tymokhin/VoltageImitator/firmware/STM32CubeIDE/вибір-платформи.md

# Вибір платформи для наступної ревізії імітатора

Вхідні вимоги: HRTIM, Ethernet на борту, **максимально точна синхронізація в
часі**, у перспективі IEC 61850 (не зараз), в ідеалі **8 силових каналів**
(4 напруги + 4 струми).

---

## 1. Перетин «HRTIM + Ethernet» — рівно одна лінійка

За таблицею застосовності в AN4539 «HRTIM cookbook» (Rev 5, червень 2025)
HRTIM існує лише в трьох сімействах STM32:

| Сімейство | HRTIM | Роздільність | Timing units | Виходів | Ethernet MAC |
|---|---|---|---|---|---|
| STM32F334 (поточний) | v1 | 217 пс | 5 | 10 | ✗ |
| STM32G474 / G484 | v2 | **184 пс** | 6 | 12 | ✗ |
| **STM32H742/743/750/753** | v1 | **2.08 нс** | 5 | 10 | ✓ + IEEE 1588 |
| **STM32H745/747/755/757** (2 ядра) | v1 | 2.08 нс | 5 | 10 | ✓ + IEEE 1588 |
| STM32H723/725/730/733/735 | ✗ | — | — | — | ✓ |
| STM32H7R/S (600 МГц, 2024) | ✗ | — | — | — | ✓ |
| STM32H5 (H563/H573) | ✗ | — | — | — | ✓ |

Два висновки, які легко пропустити:

- **«Потужніший» ≠ «має HRTIM».** H723/H725 (550 МГц) і найновіші H7R/S
  (600 МГц) HRTIM не мають узагалі, попри те що вони швидші за H743.
- **На H7 HRTIM у ~10 разів грубіший, ніж на G4 і навіть ніж на твоєму
  поточному F334.** У F3 і G4 є DLL із множенням ×32 (еквівалент 4.6–5.4 ГГц).
  На H7 його немає: HRTIM тактується напряму від 480 МГц, звідси 2.08 нс.
  Це підтверджують два незалежні документи ST.

### Що це коштує в бітах

При PWM 100 кГц (період 10 мкс):

| Чіп | Кроків duty | Ефективних біт |
|---|---|---|
| F334 (зараз) | 46 080 | 15.5 |
| G474 | 54 348 | 15.7 |
| **H743** | **4 808** | **12.2** |

Перехід на H7 заради Ethernet коштує ~3.3 біта роздільності силового каналу.

**Чому це, найімовірніше, все одно прийнятно:**

- замкнений контур виправляє середнє — квантування лишається шумом, а не
  похибкою амплітуди;
- передискретизація величезна: PWM 100 кГц проти сигналу 0–1 кГц дає
  OSR ≈ 50, тобто ~17 дБ (майже 3 біти) виграшу в смузі, якщо похибка біла;
- LC-фільтр давить решту.

**Чому про це все одно треба пам'ятати:** похибка квантування PWM НЕ біла —
вона корельована із сигналом і вилазить саме як зайві гармоніки. Для
імітатора РЗА, де 2-а гармоніка подається на рівні 15 %, а 5-а на 25 %, це
принципово. Лікується **дизерингом молодшого біта duty** (±1 LSB
псевдовипадково щотакту) — дешево, кілька рядків у гарячому циклі.

Запасний хід, якщо 12.2 біта виявляться замалими: знизити PWM до 50 кГц
(9 615 кроків = 13.2 біта) або до 20 кГц (24 038 = 14.6 біта), заплативши
складнішим фільтром.

---

## 2. Чи влізуть 8 каналів в один чіп

**Так — але за однієї умови.**

Рахунок виходів HRTIM: 5 timing units × 2 виходи = **10 виходів** на H743.
Питання лише в тому, скільки виходів з'їдає один канал, а це визначає
топологія силової частини:

| Топологія | Виходів на канал | Каналів на H743 | На G474 |
|---|---|---|---|
| Один PWM, комплементарну пару й deadtime робить драйвер затворів | 1 | **10** | 12 |
| Півміст із апаратним deadtime від HRTIM | 2 (весь timing unit) | 5 | 6 |
| Повний H-міст від HRTIM | 4 (2 units) | 2 | 3 |

Тобто **8 каналів влізуть, якщо deadtime віддати драйверам** (IR2104,
UCC27211 і подібні генерують комплементарну пару з одного входу PWM).
Якщо хочеш апаратний deadtime усередині HRTIM — стеля 5 каналів на H743
і 6 на G474, і 8 не виходить у жодному разі на одному чіпі.

Два виходи одного timing unit ділять період, але мають незалежні CMP1/CMP2 —
цей трюк уже використаний у поточній прошивці (TA1/TA2 на таймері A).
Оскільки всі канали й так працюють на 100 кГц, спільний період не заважає.

> **Перевірити перед розведенням:** скільки виходів HRTIM фізично виведено
> в обраному корпусі. У 48-вивідному F334C8 доступна лише частина; у
> LQFP144/176 на H743 ситуація краща, але це треба звірити по таблиці
> альтернативних функцій у datasheet, а не припускати.

### Бюджет ядра — перестає бути проблемою

Поточний такт (4 канали × 10 гармонік) ≈ 1800–2000 тактів на M4 @ 72 МГц.
M7 @ 480 МГц дає приблизно 1.7× по IPC плюс кеш. Оцінка для 8 каналів:

- ~2 400 тактів M7 ≈ **5 мкс**;
- при PWM 100 кГц (10 мкс) це ~50 % завантаження.

Тобто на H743 **8 каналів × 10 гармонік на повних 100 кГц стають реальними**,
без децимації. Запас усе одно варто лишити — децимація на 2 дає 25 %.

### АЦП — недооцінений аргумент за H7

| | H743 | G474 |
|---|---|---|
| Кількість АЦП | 3 | 5 |
| Роздільність | **16 біт** | 12 біт |
| Швидкодія | до 3.6 Msps | до 4 Msps |

8 каналів ЗЗ на H743 розкладаються 3/3/2. Усередині одного АЦП ранги йдуть
послідовно — при 3.6 Msps три ранги це ~1–1.5 мкс перекосу. Для 50 Гц це
0.02°, тобто нехтовно.

**Ключова думка: точність замкненого контуру обмежена датчиком, а не
виконавчим органом.** Регулятор виправляє рівно те, що бачить. Перехід
12 → 16 біт на вимірюванні дає більше, ніж 3 біти PWM, які контур і
фільтр здебільшого згладжують. Це серйозно схиляє шальки до H7, попри
грубіший HRTIM.

---

## 3. Синхронізація в часі — головна вимога

Тут є три речі, які варто розділити.

### PTP — не найточніший варіант

- **GNSS PPS:** 10–50 нс до UTC, без залежності від мережі. Пін PPS у
  твоїй схемі вже є.
- **PTP (IEEE 1588v2) з апаратним мітками часу:** зазвичай суб-мікросекунда,
  ~100 нс — але **лише якщо весь шлях PTP-aware** (boundary/transparent
  clocks у комутаторах). У звичайній мережі буде помітно гірше.
- **IRIG-B:** ~1 мкс, класика для підстанцій.

Тобто якщо мета — максимальна точність, **основним джерелом має бути GNSS
PPS**, а PTP — резервом на випадок, коли антену не вивести, плюс шлях до
IEC 61850-9-3 у майбутньому. Ethernet заради синхронізації сам по собі
не обов'язковий; він потрібен для 61850 і зручності.

### Обмежувач точності — кварц, а не мікроконтролер

Звичайний кварц ±10 ppm дає дрейф 10 мкс за секунду — це **0.18° від 50 Гц
між імпульсами PPS**. Ніякий вибір МК цього не виправить.

| Джерело | Стабільність | Дрейф фази 50 Гц за 1 с |
|---|---|---|
| Кварц ±10 ppm | 10 ppm | 0.18° |
| TCXO ±0.5 ppm | 0.5 ppm | 0.009° |
| Малий OCXO ±0.01 ppm | 0.01 ppm | 0.0002° |

**Заміна кварцу на TCXO (а краще OCXO) на вході HSE — більший важіль
точності, ніж вибір між H743 і G474.** Це найдешевше покращення в усьому
проєкті.

### Дисциплінувати треба фазу хвилі, а не таймбазу PWM

Спокуса — підстроювати HRTIM під PPS. Не треба: це ламає і період PWM, і
частоту АЦП, і весь розрахунок регулятора.

Правильно: лишити HRTIM вільно бігти від кварцу, а дисциплінувати
**фазовий акумулятор**. Він уже Q32, тобто крок `phase_step` можна
підкручувати на одиниці ppb — це керує фазою вихідного сигналу з
роздільністю, недосяжною для будь-якого підстроювання таймера.

Схема:

1. Захопити PPS входом таймера (input capture).
2. Порівняти з лічильником тактів контуру → похибка фази.
3. Повільний ФАПЧ (смуга частки герца) підкручує `phase_step` усіх каналів
   однаково.

Це чисто прошивкова функція, працює на будь-якому з розглянутих чіпів,
і поточна структура коду (`WgPhaseStep`, `phase_acc` на канал) уже під неї
готова — треба додати спільний множник корекції.

Бонус H743: блок PTP має вихід PPS, тобто можна **видавати** власний PPS і
на осцилографі звіряти GNSS проти PTP проти власної шкали.

---

## 4. Один чіп, два чіпи чи двоядерний

### Двоядерний H747/H755 — не рекомендую як перший крок

Виглядає привабливо (M7 на мережу, M4 на контур), але це фактично два
проєкти в одному корпусі, плюс специфічні граблі:

- M7 має D-cache, M4 не має → спільну пам'ять треба вручну позначати
  non-cacheable через MPU, інакше отримуєш плаваючі баги когерентності;
- синхронізація через HSEM;
- послідовність завантаження двох ядер, два сеанси відладки, дві збірки.

Для людини, яка з двоядерними не працювала, це помітний ризик — а виграш
малий, бо одноядерний H743 на 480 МГц і так має запас і на контур, і на lwIP.

### Два окремі чіпи (G474 + мережевий) — план Б

Має сенс, **якщо роздільність PWM виявиться критичною**. G474 — це буквально
чіп під цю задачу:

- HRTIM v2, 184 пс, 6 timing units / 12 виходів;
- **CORDIC** — апаратний sin/cos, викидає LUT із гарячого циклу;
- **FMAC** — апаратний FIR/IIR, може рахувати резонатор без CPU;
- 5 АЦП, 7 компараторів і 6 ОП на кристалі (аналогове узгодження й
  апаратний захист по струму прямо в МК).

Ціна: два проєкти, два тулчейни, протокол по SPI між чіпами.

### Рекомендація: одноядерний STM32H743 / H753

| Аргумент | |
|---|---|
| Єдине сімейство з HRTIM + Ethernet + IEEE 1588 | ✓ |
| 480 МГц M7 — бюджет ядра перестає бути обмеженням | ✓ |
| 16-бітні АЦП замість 12-бітних — реальний виграш точності контуру | ✓ |
| 1 МБ RAM — жодних танців із CCM | ✓ |
| 10 виходів HRTIM → 8 каналів влізають | ✓ |
| Один проєкт, HAL той самий, код портується майже прямо | ✓ |
| HRTIM 2.08 нс замість 217 пс | ✗ (лікується дизерингом) |

H753 замість H743 — якщо колись знадобиться криптографія (наприклад,
захищений доступ до приладу). Різниця тільки в цьому.

---

## 5. Альтернатива поза ST: TI C2000 F2838x — ВІДХИЛЕНО

Чесно кажучи, для цієї задачі TMS320F28388D підходить **краще за H743**:

| | F28388D | STM32H743 |
|---|---|---|
| Ядра | 2× C28x @200 МГц + Cortex-M4 @125 МГц | 1× M7 @480 МГц |
| PWM | 32 канали, з них 16 високої роздільності | 10 виходів HRTIM |
| Ethernet | 10/100 з 1588 | 10/100 з 1588 |
| АЦП | 4×, 16 біт @1.1 Msps або 12 біт @3.5 Msps | 3×, 16 біт @3.6 Msps |
| Мережа | окремий M4 «connectivity manager» — не заважає реального часу | той самий M7 |

HRPWM у C2000 класу ~150 пс, тобто кращий за H7 і зіставний із G4. Плюс
виділений M4 під мережу — реально-часові ядра не смикаються стеком TCP/IP.

**Але:** повністю інша екосистема (Code Composer Studio, компілятор C28x,
driverlib замість HAL). Наявний код не портується, крива навчання реальна.

**Рішення: відхилено.** Немає досвіду з TI, а починати новий продукт
одночасно з новою екосистемою — це складати два ризики. Виграш у
роздільності PWM того не вартий, тим паче що його можна перевірити
експериментом (розділ 6) і, за потреби, закрити дизерингом або
переходом на G474, лишаючись у знайомому GCC/HAL.

---

## 6. Порядок дій

> **Рішення прийняте: STM32H743 (або H753), одноядерний.**
> TI відхилено через відсутність досвіду з екосистемою. Двоядерний H747
> відхилено як зайвий ризик на першому кроці. G474 + окремий мережевий
> чіп лишається планом Б на випадок, якщо крок 0 нижче провалиться.

### Крок 0 — зробити ПЕРШИМ, на наявній платі F334

Єдине неперевірене припущення в усьому рішенні — чи прийнятні 12.2 біта
PWM. Його не треба перевіряти на новому залізі: 46080 / 4808 = 9.6, тому
квантування compare кроком 10 тіків емулює H743 прямо в поточному тракті.

У прошивку додано дві константи (`WG_DUTY_QUANT_TICKS`, `WG_DUTY_DITHER`)
і дизеринг. Зняти три виміри THD і рівнів 2-ї та 5-ї гармонік при
однаковому завданні:

| `QUANT` | `DITHER` | Що це |
|---|---|---|
| 0 | — | рідні 15.5 біта, еталон |
| 10 | 0 | H743 у найгіршому випадку |
| 10 | 1 | H743 із пом'якшенням |

Якщо третій близький до першого — H743 безпечний, замовляти Nucleo.
Якщо ближчий до другого — план Б.

### Далі — макет

Не розводити плату одразу. Спочатку макет на Nucleo-144 з H743/H753 —
там RJ45 і PHY вже на борту (ST зараз рекомендує NUCLEO-H753ZI; стара
NUCLEO-H743ZI знята з виробництва).

Перевірити в такому порядку:

1. **HRTIM 2.08 нс через реальний LC-фільтр.** Зібрати один канал,
   замкнути контур, зміряти THD і рівень окремих гармонік. Це **та єдина
   цифра, яка вирішує, чи прийнятний H7 узагалі.** Перевірити окремо
   з дизерингом і без.
2. **Дисциплінування фази по PPS.** Захоплення PPS, повільний ФАПЧ на
   `phase_step`, вимірювання дрейфу фази на осцилографі. Спробувати з
   кварцом і з TCXO, щоб побачити різницю.
3. **lwIP + PTP.** Найпростіше з трьох і найменш ризиковане.

Якщо (1) провалиться — перехід на план Б: G474 на силову частину плюс
окремий мережевий чіп.

Поточну плату на F334 лишити як стенд: на ній зручно доводити регулятор і
силову частину, поки макет H7 тільки збирається.

---

## Джерела

- [AN4539 HRTIM cookbook, Rev 5 (червень 2025)](https://www.st.com/resource/en/application_note/an4539-hrtim-cookbook-stmicroelectronics.pdf) — таблиця застосовності: які сімейства мають HRTIM, роздільність, кількість timing units
- [STM32G4/H7 Digital Power Application Sharing](https://manuals.plus/m/1cf4d2a43a0bee1e43a5e4415d6ce97a58c221965ac72a7ffb454052e28073fd) — 184 пс на G4 проти 2.2 нс на H7
- [STM32H7x3 product brief](https://my.avnet.com/wcm/connect/d6ffc27e-608a-4760-b78c-f9ce36de3c60/AVS-094-E_ST_STM32H7_product-brief.pdf?id=1516619058577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) — Ethernet MAC 10/100 з IEEE 1588, 3× 16-бітних АЦП, high-resolution timer
- [STM32H7R3A8 datasheet](https://mm.digikey.com/Volume0/opasdata/d220001/medias/docus/8909/stm32h7r3a8.pdf) — підтвердження, що H7R/S має Ethernet, але не має HRTIM
- [STM32H72x/H73x product overview](https://www.st.com/resource/en/product_presentation/microcontrollers_stm32h72x-3x_line_product-overview.pdf) — 550 МГц лінійка
- [TMS320F28388D datasheet](https://www.ti.com/lit/ds/symlink/tms320f28388d.pdf) — 32 PWM-канали (16 високої роздільності), Ethernet 1588, 4× АЦП 16 біт
- [NUCLEO-H743ZI / H753ZI](https://www.st.com/en/evaluation-tools/nucleo-h743zi.html) — макетна плата з Ethernet
