tymokhin/VoltageImitator/hardware/v1/VoltageImitator.pdf

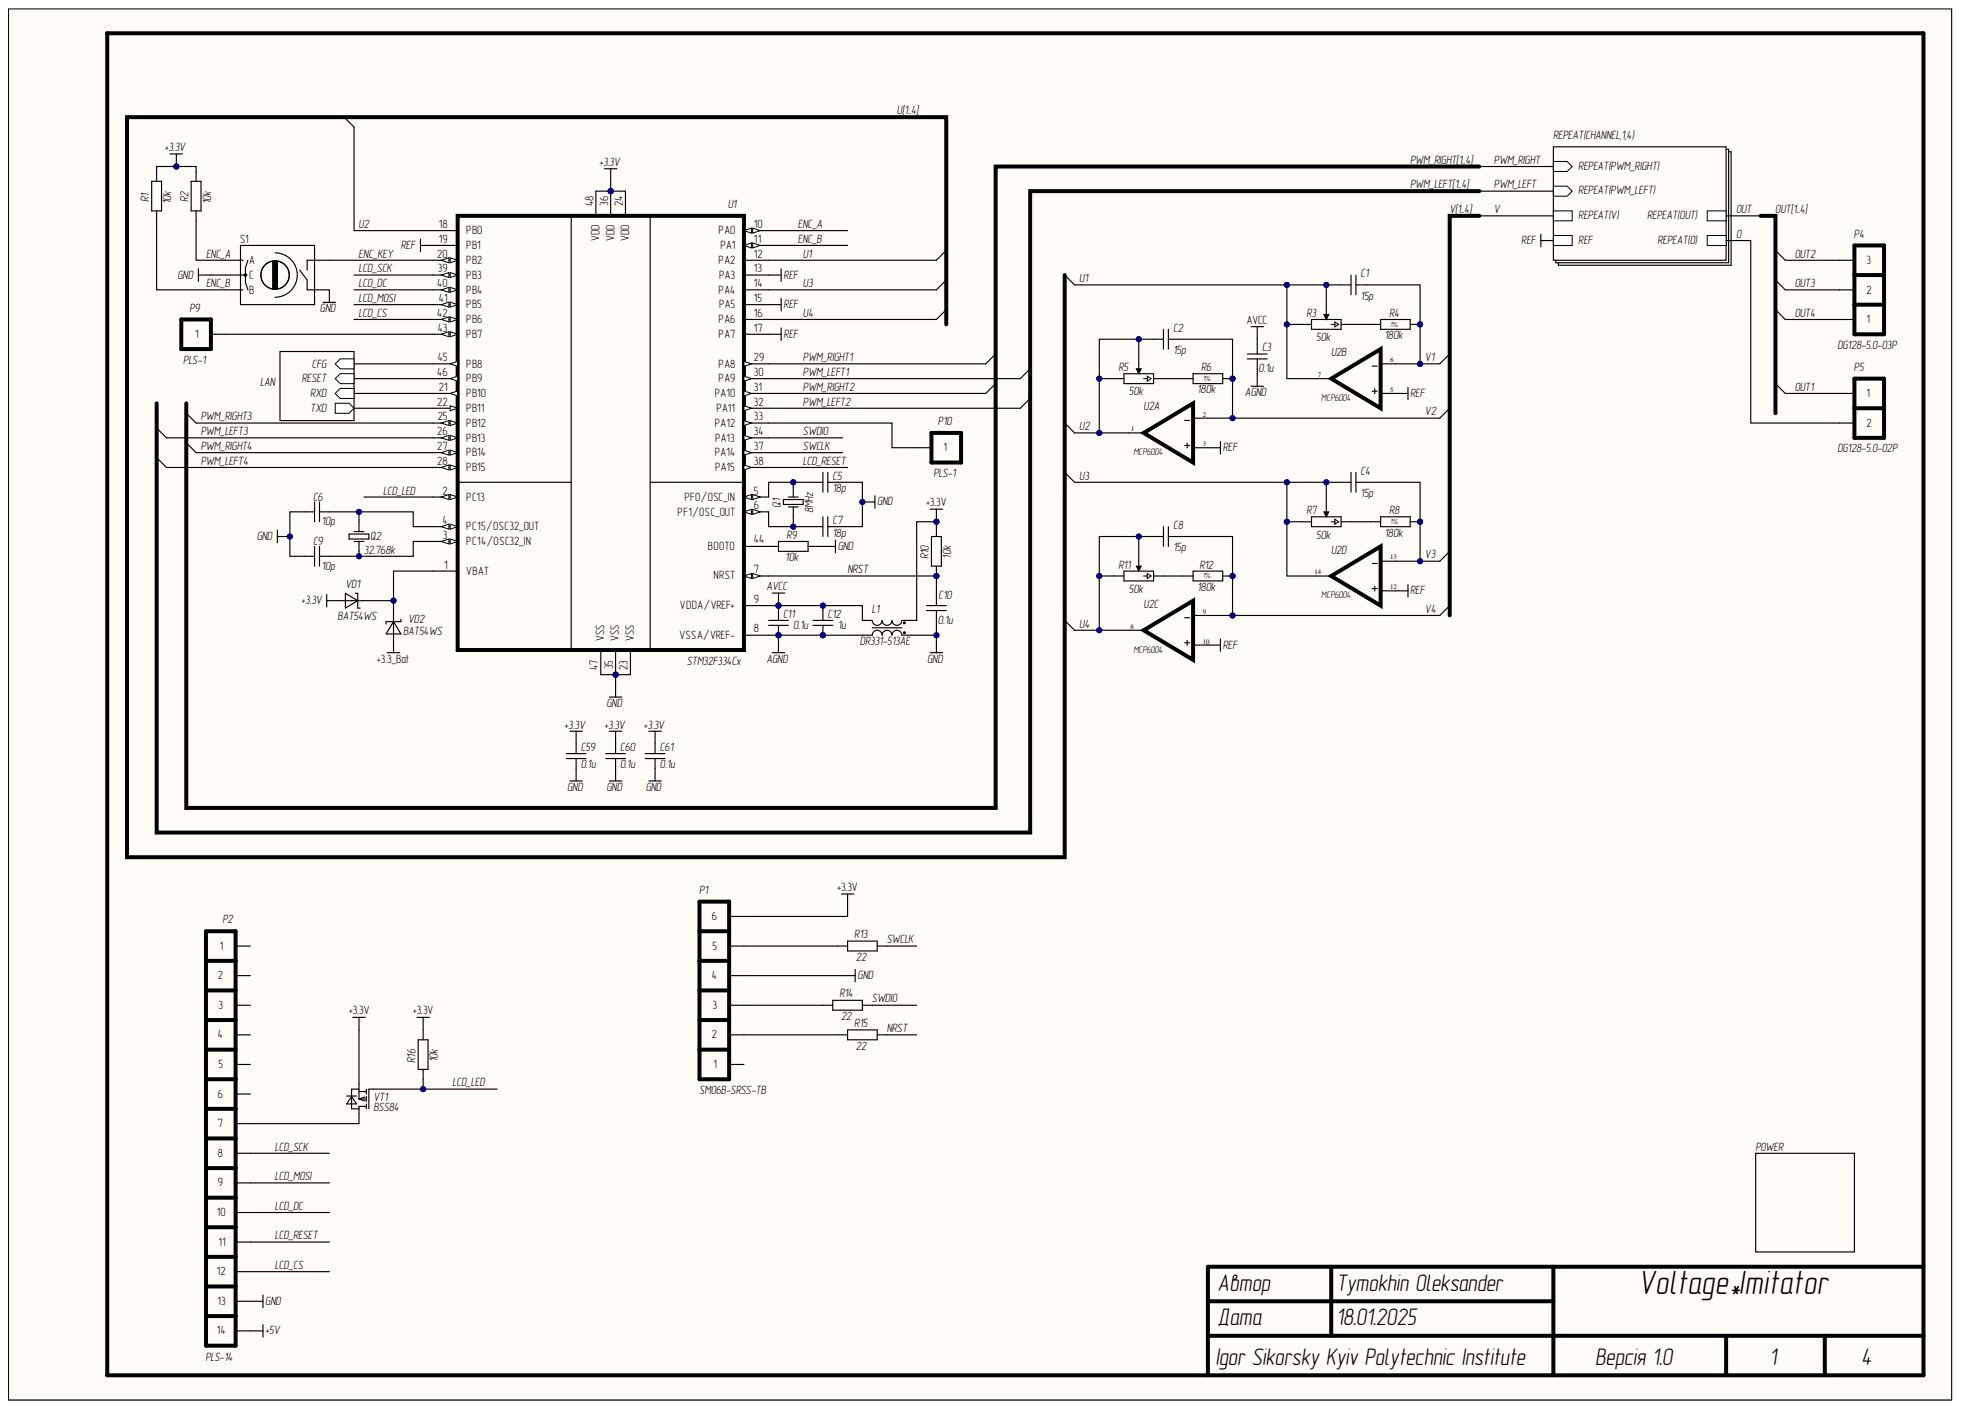
[picture p1: page 1]

PWM_LEFT[1..4] | PWM_LEFT

Автор | Tymokhin Oleksander | Voltage Imitator *
Дата | 18.01.2025
Igor Sikorsky Kyiv Polytechnic Institute | Версiя 1.0

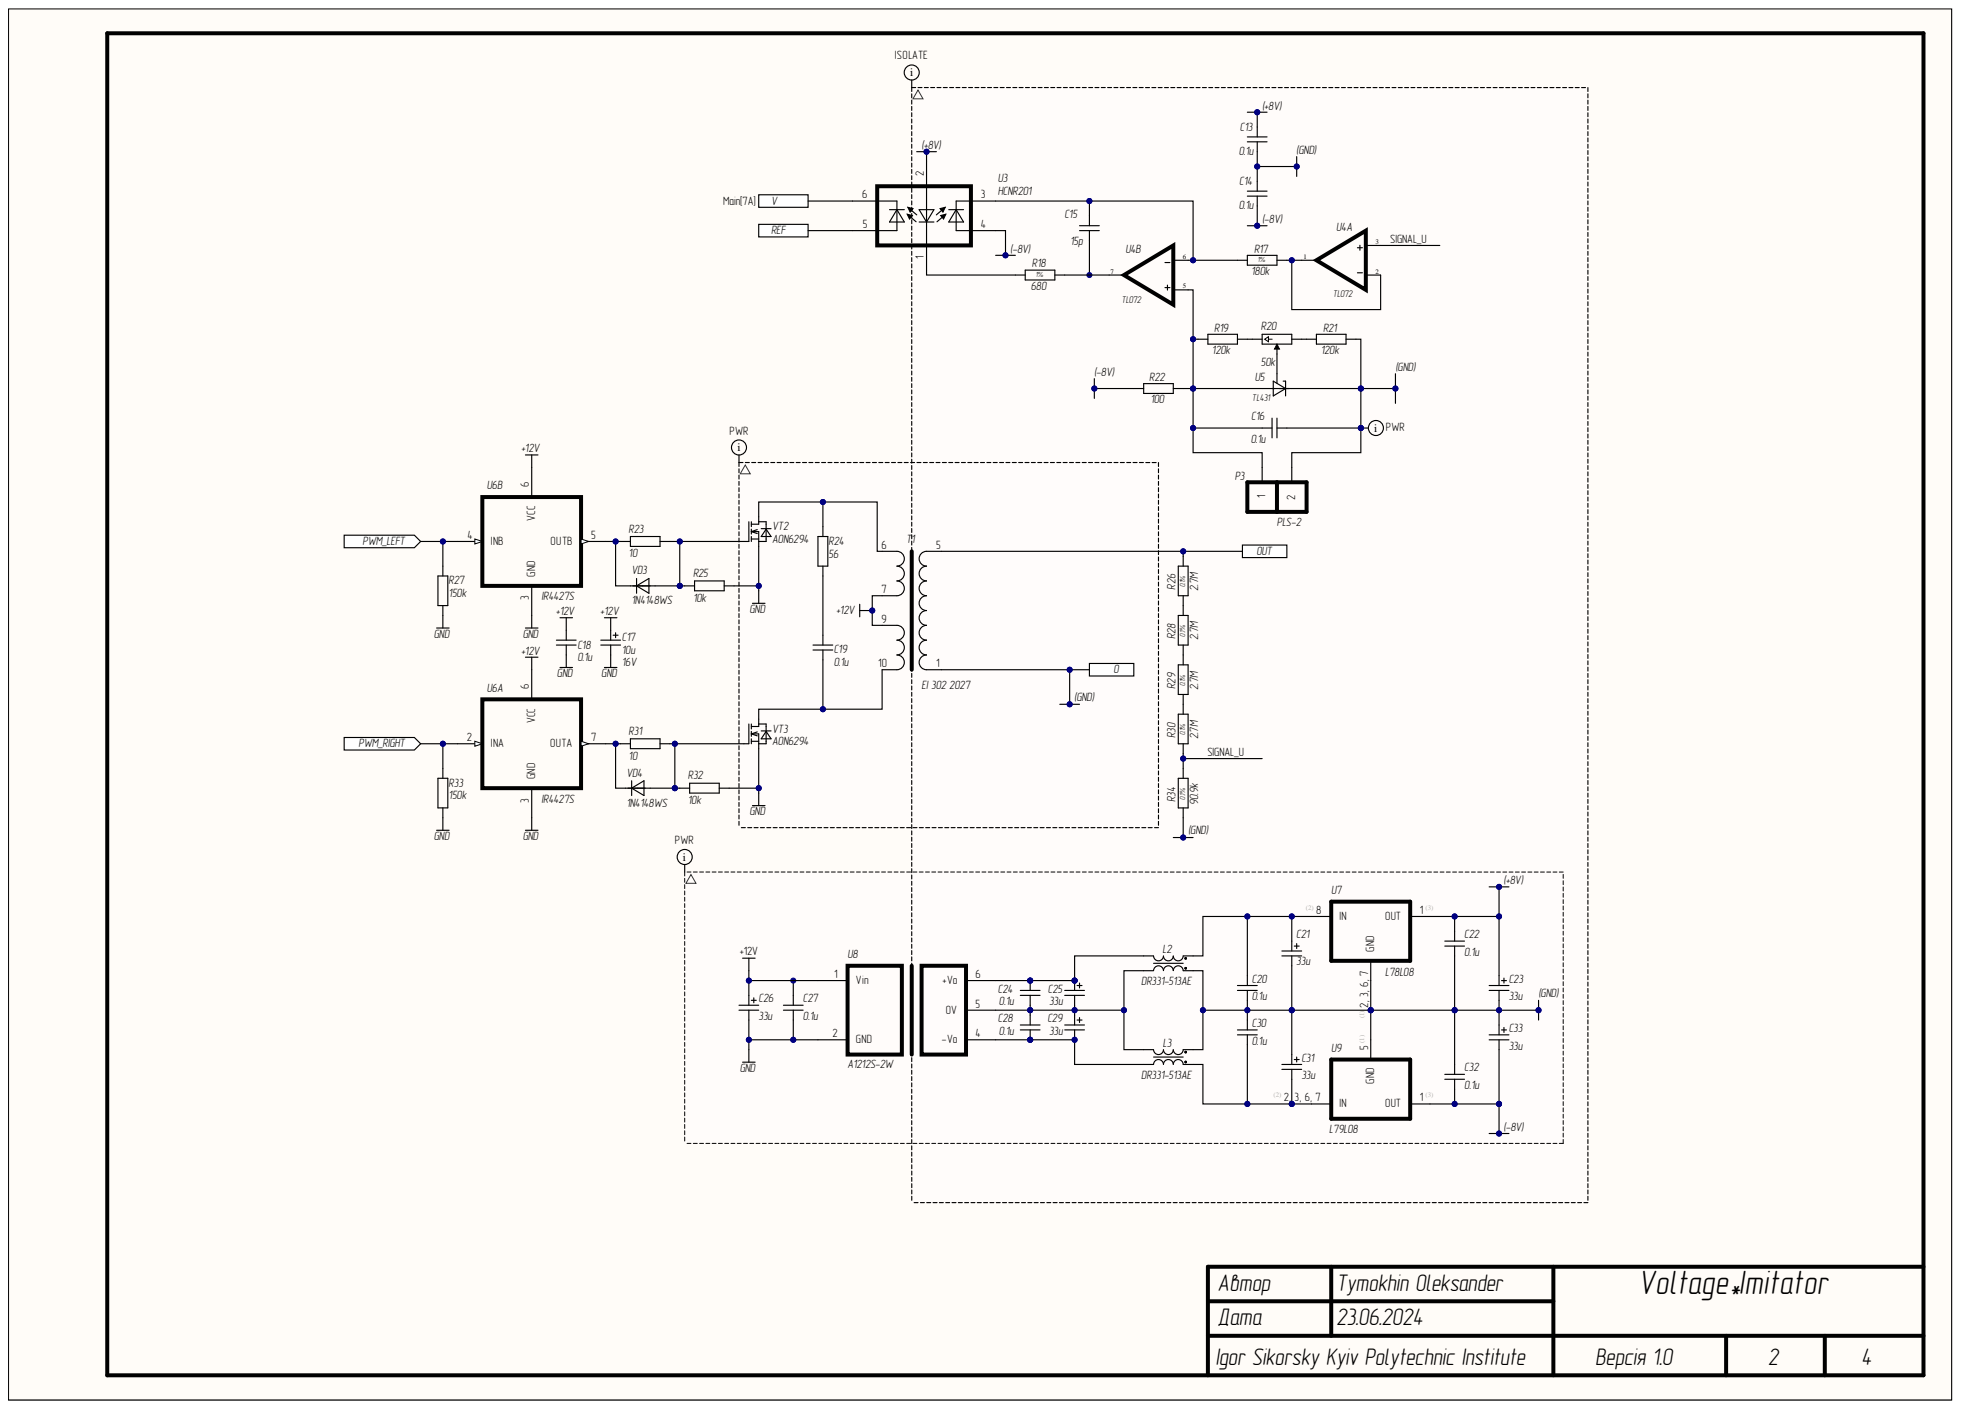
[picture p2: page 2]

Автор | Tymokhin Oleksander | Voltage Imitator *
Дата | 23.06.2024

Версiя 1.0

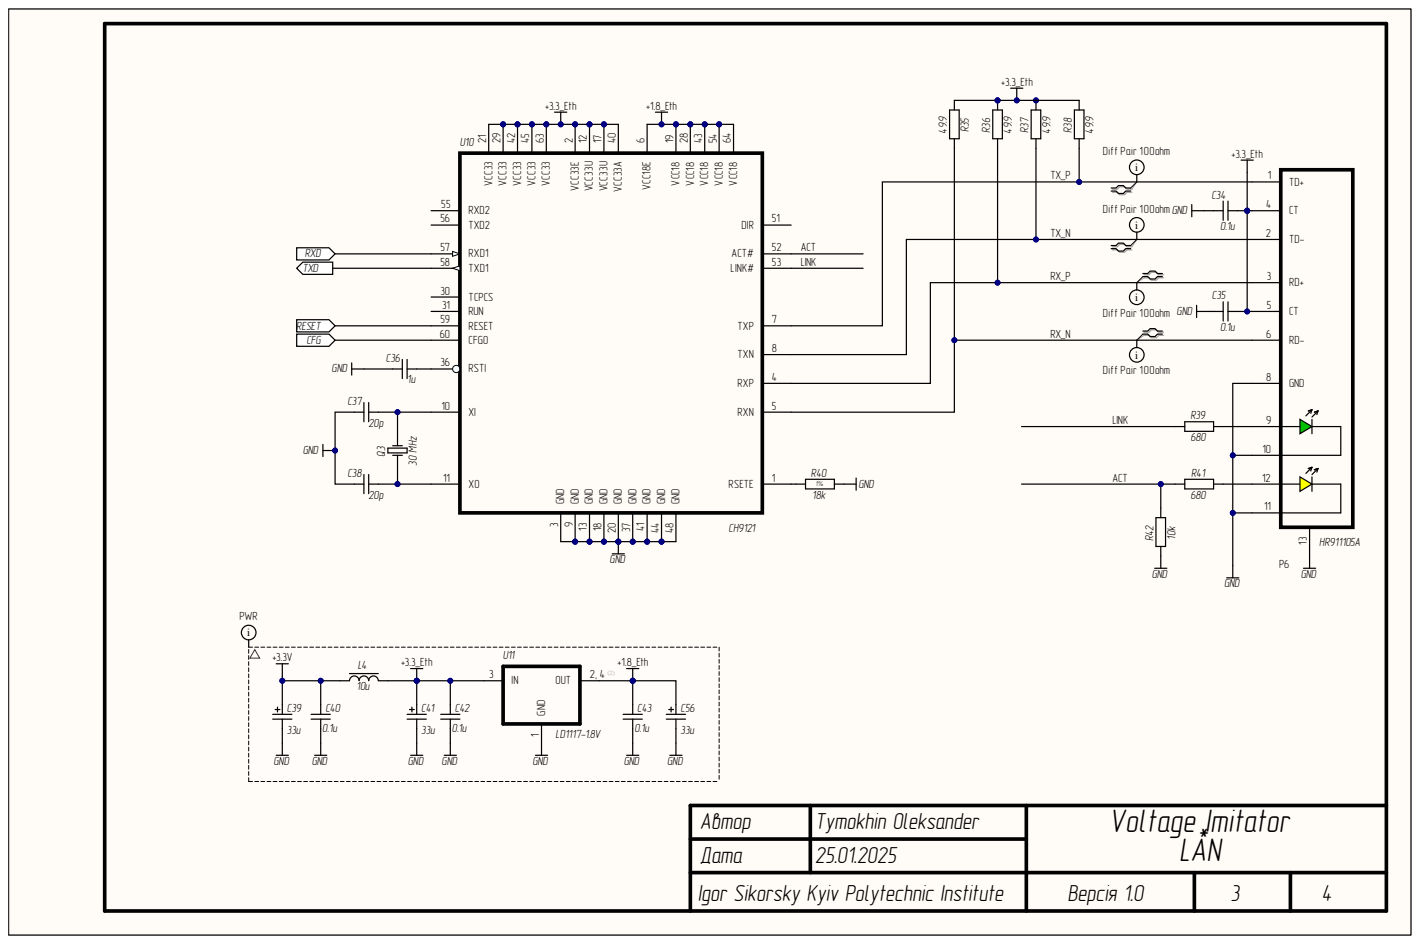
[picture p3: page 3]

Автор | Tymokhin Oleksander | Voltage Imitator * LAN
Дата | 25.01.2025

Версiя 1.0

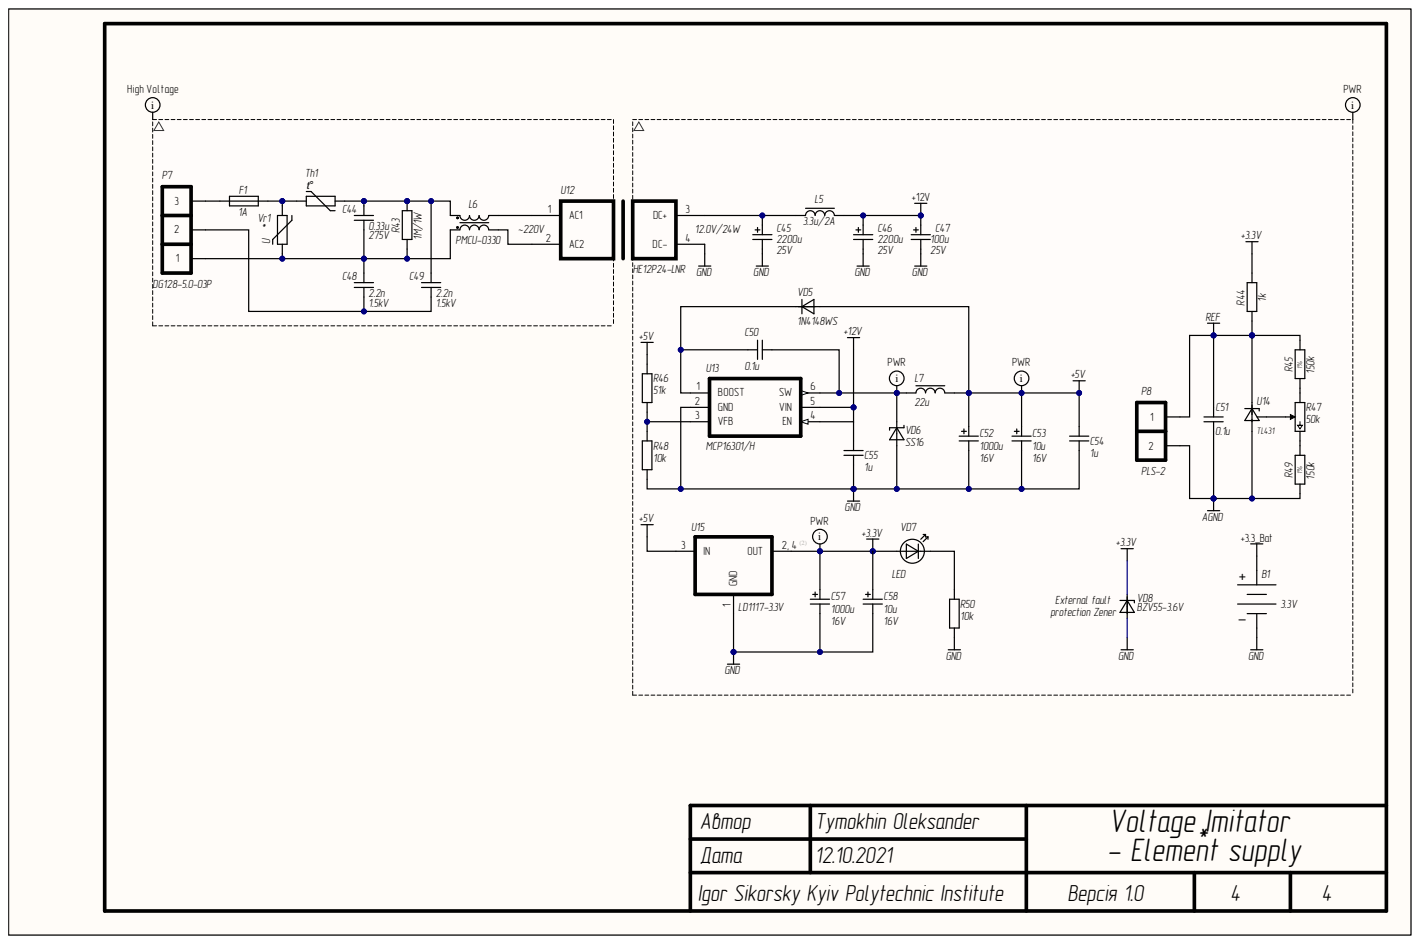
[picture p4: page 4]

Автор | Tymokhin Oleksander | Voltage Im itator * - Element supply
Дата | 12.10.2021

Версiя 1.0 | 4 | 4
