tymokhin/VoltageImitator/(list of files, drawings)

Other design files:
hardware/Board.PcbDoc
hardware/Channel.SchDoc
hardware/LAN.SchDoc
hardware/Main.SchDoc
hardware/Power.SchDoc
hardware/v1/Board.PcbDoc
hardware/v1/Channel.SchDoc
hardware/v1/LAN.SchDoc
hardware/v1/Main.SchDoc
hardware/v1/Power.SchDoc
hardware/v1/VoltageImitator_v1.PrjPcb
hardware/VoltageImitator.PrjPcb
model/Multisim/ACS712 (Hall sensor) model.ms14
model/Multisim/Voltage Mesaurment (clode).ms14
model/Multisim/Voltage Mesaurment (unipolr stm32).ms14
model/Multisim/Voltage Mesaurment (unipolr).ms14
