tymokhin/VoltageImitator/firmware/STM32CubeIDE/Core/Src/main.c

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
/* Includes ------------------------------------------------------------------*/
#include "main.h"

/* USER CODE BEGIN Includes */
#include "FreeRTOS.h"
#include "task.h"
#include "uart_task.h"
#include "wave_generator_task.h"
/* USER CODE END Includes */

ADC_HandleTypeDef hadc1;
ADC_HandleTypeDef hadc2;
DMA_HandleTypeDef hdma_adc1;

HRTIM_HandleTypeDef hhrtim1;

SPI_HandleTypeDef hspi1;

TIM_HandleTypeDef htim2;

UART_HandleTypeDef huart3;

void SystemClock_Config(void);
static void MX_GPIO_Init(void);
static void MX_DMA_Init(void);
static void MX_HRTIM1_Init(void);
static void MX_ADC1_Init(void);
static void MX_ADC2_Init(void);
static void MX_USART3_UART_Init(void);
static void MX_TIM2_Init(void);
static void MX_SPI1_Init(void);
/**
  * @brief  The application entry point.
  * @retval int
  */
int main(void)
{

  /* MCU Configuration--------------------------------------------------------*/

  /* Reset of all peripherals, Initializes the Flash interface and the Systick. */
  HAL_Init();

  /* Configure the system clock */
  SystemClock_Config();

  /* Initialize all configured peripherals */
  MX_GPIO_Init();
  MX_DMA_Init();
  MX_HRTIM1_Init();
  MX_ADC1_Init();
  MX_ADC2_Init();
  MX_USART3_UART_Init();
  MX_TIM2_Init();
  MX_SPI1_Init();
  /* USER CODE BEGIN 2 */
  /*
   * Прив'язка чотирьох каналів.
   *
   *  ch | вихід HRTIM | таймер | compare | зворотний зв'язок
   * ----+-------------+--------+---------+---------------------------------
   *   0 | TA1  (PA8)  |   A    |  CMP1   | ADC1 rank1, CH3 diff PA2/PA3  <- розпаяно
   *   1 | TA2  (PA9)  |   A    |  CMP2   | ADC1 rank2, CH11     PB0
   *   2 | TB1  (PA10) |   B    |  CMP1   | ADC2 rank1, CH1 diff PA4
   *   3 | TB2  (PA11) |   B    |  CMP2   | ADC2 rank2, CH3 diff PA6
   *
   * Два виходи на один таймер - це нормально: TA1 керується CMP1, TA2 - CMP2,
   * період у них спільний, а шпаруватість незалежна. Так із двох таймерів
   * виходить чотири незалежні канали.
   */
  WaveGeneratorHardwareConfig wave_generator_hw = {
      .adc_master = &hadc1,
      .adc_slave  = &hadc2,
      .hrtim      = &hhrtim1,
      .pwm_output_mask = HRTIM_OUTPUT_TA1 | HRTIM_OUTPUT_TA2 |
                         HRTIM_OUTPUT_TB1 | HRTIM_OUTPUT_TB2,
      .counter_start_mask = HRTIM_TIMERID_MASTER | HRTIM_TIMERID_TIMER_A |
                            HRTIM_TIMERID_TIMER_B,
      .sampling_trigger_index = HRTIM_ADCTRIGGER_1,
      .channel = {
          [WG_CH_UA] = {
              .hrtim_timer_index  = HRTIM_TIMERINDEX_TIMER_A,
              .hrtim_compare_unit = HRTIM_COMPAREUNIT_1,
              .hrtim_output       = HRTIM_OUTPUT_TA1,
              .feedback_source    = WAVE_GENERATOR_FEEDBACK_MASTER_RANK1,
              .feedback_enabled   = (WG_CH0_FEEDBACK_ENABLED != 0),
          },
          [WG_CH_UB] = {
              .hrtim_timer_index  = HRTIM_TIMERINDEX_TIMER_A,
              .hrtim_compare_unit = HRTIM_COMPAREUNIT_2,
              .hrtim_output       = HRTIM_OUTPUT_TA2,
              .feedback_source    = WAVE_GENERATOR_FEEDBACK_MASTER_RANK2,
              .feedback_enabled   = (WG_CH1_FEEDBACK_ENABLED != 0),
          },
          [WG_CH_UC] = {
              .hrtim_timer_index  = HRTIM_TIMERINDEX_TIMER_B,
              .hrtim_compare_unit = HRTIM_COMPAREUNIT_1,
              .hrtim_output       = HRTIM_OUTPUT_TB1,
              .feedback_source    = WAVE_GENERATOR_FEEDBACK_SLAVE_RANK1,
              .feedback_enabled   = (WG_CH2_FEEDBACK_ENABLED != 0),
          },
          [WG_CH_3U0] = {
              .hrtim_timer_index  = HRTIM_TIMERINDEX_TIMER_B,
              .hrtim_compare_unit = HRTIM_COMPAREUNIT_2,
              .hrtim_output       = HRTIM_OUTPUT_TB2,
              .feedback_source    = WAVE_GENERATOR_FEEDBACK_SLAVE_RANK2,
              .feedback_enabled   = (WG_CH3_FEEDBACK_ENABLED != 0),
          },
      },
  };
  UartControlHardwareConfig uart_control_hw = {
      .uart = &huart3,
      .irqn = USART3_IRQn,
  };

  WaveGenerator_BindHardware(&wave_generator_hw);
  WaveGenerator_Init();

  UartControl_BindHardware(&uart_control_hw);
  UartControl_Init();
  /* USER CODE END 2 */

  /* Infinite loop */
  /* USER CODE BEGIN WHILE */

  vTaskStartScheduler();
  while (1)
  {
    /* USER CODE END WHILE */

    /* USER CODE BEGIN 3 */
  }
  /* USER CODE END 3 */
}

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
/**
  * @brief  Period elapsed callback in non blocking mode
  * @note   This function is called  when TIM1 interrupt took place, inside
  * HAL_TIM_IRQHandler(). It makes a direct call to HAL_IncTick() to increment
  * a global variable "uwTick" used as application time base.
  * @param  htim : TIM handle
  * @retval None
  */
void HAL_TIM_PeriodElapsedCallback(TIM_HandleTypeDef *htim)
{
  if (htim->Instance == TIM1)
  {
    HAL_IncTick();
  }
}

/**
  * @brief  This function is executed in case of error occurrence.
  * @retval None
  */
void Error_Handler(void)
{
  /* USER CODE BEGIN Error_Handler_Debug */
  /* User can add his own implementation to report the HAL error return state */
  __disable_irq();
  while (1)
  {
  }
  /* USER CODE END Error_Handler_Debug */
}
#ifdef USE_FULL_ASSERT
/**
  * @brief  Reports the name of the source file and the source line number
  *         where the assert_param error has occurred.
  * @param  file: pointer to the source file name
  * @param  line: assert_param error line source number
  * @retval None
  */
void assert_failed(uint8_t *file, uint32_t line)
{
  /* USER CODE BEGIN 6 */
  /* User can add his own implementation to report the file name and line number,
     ex: printf("Wrong parameters value: file %s on line %d\r\n", file, line) */
  /* USER CODE END 6 */
}
#endif /* USE_FULL_ASSERT */
