tymokhin/VoltageImitator/firmware/STM32CubeIDE/Task/wave_generator_config.h

/*
 * wave_generator_config.h
 *
 * Єдина точка налаштування генератора/регулятора.
 *
 * УСЕ, що тут визначено, задумано як тимчасові константи. Коли з'явиться
 * конфігурування по каналу зв'язку, ці значення стануть просто default-ами,
 * а структури WaveGeneratorChannelConfig / WaveGeneratorLoopGains /
 * WaveGeneratorFeedbackConfig будуть заповнюватись ззовні без переробки
 * логіки в wave_generator_task.c.
 */

#ifndef WAVE_GENERATOR_CONFIG_H_
#define WAVE_GENERATOR_CONFIG_H_

/* ==========================================================================
 * 1. Тактування
 * ==========================================================================
 *
 * f_HRTIM = 144 MHz (PLL x2, RCC_HRTIM1CLK_PLLCLK при SYSCLK = 72 MHz).
 *
 *   Timer A / Timer B : PRESCALERRATIO_MUL32 -> 32 * 144 MHz = 4.608 GHz
 *                       PWM_PERIOD = 46080 тіків -> 10 us -> 100 kHz PWM
 *
 *   Master            : PRESCALERRATIO_MUL4  ->  4 * 144 MHz = 576 MHz
 *                       1 період PWM = 5760 тіків master
 *
 * Період master задає частоту ADC-тригера, тобто частоту контуру керування:
 *
 *   master_period = WG_CONTROL_DECIMATION * 5760
 *   f_control     = 100 kHz / WG_CONTROL_DECIMATION
 *
 * Обмеження HRTIM: період master при CKPSC=3 (MUL4) <= 0xFFFD = 65533,
 * тобто WG_CONTROL_DECIMATION <= 11.
 *
 * Чому не 1 (тобто не 100 kHz)?
 *   На 72 MHz один такт контуру при 100 kHz = 720 тактів ядра. Цього
 *   вистачає рівно на один канал без гармонік. Синтез 4 каналів по 10
 *   гармонік + PI + резонатор + накладні витрати HAL_DMA_IRQHandler
 *   вимагає ~2000-2500 тактів. Тому 4 -> 25 kHz (2880 тактів/такт) із
 *   запасом. 25 kHz дає 500 точок на період 50 Hz і Найквіст 12.5 kHz,
 *   тобто 10-та гармоніка (500 Hz) відтворюється з великим запасом.
 */
#define WG_PWM_PERIOD_TICKS            46080U   /* = PWM_PERIOD з main.h */
#define WG_PWM_FREQ_HZ                 100000UL
#define WG_MASTER_TICKS_PER_PWM        5760U    /* PWM period у тіках master (MUL4) */
#define WG_CONTROL_DECIMATION          4U       /* 1..8; 4 -> контур 25 kHz */

/* --------------------------------------------------------------------------
 * Придушення пульсацій PWM у каналі зворотного зв'язку
 * --------------------------------------------------------------------------
 *
 * Виміряно на платі: при статичних 50 % шпаруватості на вході АЦП близько
 * 600 мВ розмаху пульсацій частоти комутації. Це ~745 відліків АЦП, тобто
 * ~31 % від корисного сигналу. Одна вибірка за такт означала б, що регулятор
 * бачить переважно пульсацію, а не сигнал. Гірше: контур працює на 25 кГц,
 * а вміст на вході 100 кГц і вище - усе, що не кратне 25 кГц, згортається
 * прямо в смугу сигналу і в цифрі вже не фільтрується.
 *
 * Рішення без жодної зміни заліза: брати кілька вибірок, РІВНОМІРНО
 * рознесених ВСЕРЕДИНІ періоду PWM, і усереднювати їх.
 *
 * Ключова деталь: вибірки мають лягати всередину періоду пульсації, а не
 * через період. N вибірок, рівномірно розкладених на один період, дають
 * ковзне середнє, у якого нуль АЧХ припадає рівно на частоту пульсації та
 * її гармоніки - тобто пульсація гаситься за побудовою, а не послаблюється.
 *
 * Реалізовано через master CMP1..CMP4: регістр ADC1R у HRTIM приймає МАСКУ
 * подій, тому один ADC-тригер можна зібрати з кількох compare. Переривань це
 * не додає взагалі: DMA накопичує всі вибірки, а переривання завершення
 * передачі приходить один раз за такт контуру.
 *
 * Обмеження за часом АЦП: при 4 тригерах на період вікно між ними 2.5 мкс,
 * а за цей час треба встигнути 2 ранги. При 72 МГц і часі вибірки 19.5
 * циклів одна конверсія 0.44 мкс, дві - 0.89 мкс. Запас майже втричі.
 * З рідними 61.5 циклами вийшло б 2.06 мкс із 2.5 - і будь-який джитер
 * призвів би до втрати тригера, а втрачений тригер зриває вирівнювання
 * буфера DMA і зупиняє контур. Тому час вибірки зменшено.
 *
 * Якщо джерело сигналу високоомне (>10 кОм), поверни 61.5 циклів і постав
 * WG_ADC_TRIGGERS_PER_PWM = 2 - придушення буде слабшим, але коректним.
 */
#define WG_ADC_TRIGGERS_PER_PWM        4U       /* 1, 2 або 4 */
#define WG_ADC_SAMPLETIME              ADC_SAMPLETIME_19CYCLES_5

/* Скільки груп «rank1+rank2» накопичує DMA за один такт контуру. */
#define WG_ADC_GROUPS_PER_TICK         (WG_ADC_TRIGGERS_PER_PWM * WG_CONTROL_DECIMATION)

/* ==========================================================================
 * 2. Канали
 * ==========================================================================
 *
 *  ch | призначення | вихід HRTIM | таймер | compare | ЗЗ (ADC)
 * ----+-------------+-------------+--------+---------+-------------------------
 *   0 | UA          | TA1  (PA8)  |   A    |  CMP1   | ADC1 rank1, CH3  diff PA2/PA3
 *   1 | UB          | TA2  (PA9)  |   A    |  CMP2   | ADC1 rank2, CH11      PB0
 *   2 | UC          | TB1  (PA10) |   B    |  CMP1   | ADC2 rank1, CH1  diff PA4
 *   3 | 3U0 / Un    | TB2  (PA11) |   B    |  CMP2   | ADC2 rank2, CH3  diff PA6
 *
 * Канал 3 навмисно НЕ "нуль" у сенсі нейтралі, а незалежне джерело 3U0 (Un).
 * Для перевірки РЗА це потрібніше: у більшості терміналів є окремий вхід
 * 3U0 (розімкнений трикутник), і його треба вміти подати незалежно від
 * суми Ua+Ub+Uc - саме так перевіряють напрямлений земляний захист і
 * логіку "хибний 3U0".
 */
#define WG_CHANNEL_COUNT               4U

#define WG_CH_UA                       0U
#define WG_CH_UB                       1U
#define WG_CH_UC                       2U
#define WG_CH_3U0                      3U

/* Скільки каналів реально розпаяно по зворотному зв'язку.
 * Зараз - лише канал 0 (PA2 сигнал / PA3 опора, диференційний вхід).
 * Канали без ЗЗ автоматично працюють у розімкненому контурі (тільки
 * feedforward), регулятор для них не рахується взагалі. */
#define WG_CH0_FEEDBACK_ENABLED        1
#define WG_CH1_FEEDBACK_ENABLED        0
#define WG_CH2_FEEDBACK_ENABLED        0
#define WG_CH3_FEEDBACK_ENABLED        0

/* ==========================================================================
 * 3. Гармоніки
 * ==========================================================================
 *
 * Індекс 0 = основна (1-а гармоніка), індекс k = гармоніка порядку k+1.
 *
 * Які гармоніки реально потрібні імітатору для РЗА:
 *
 *   2-а  - КЛЮЧОВА. Кидок струму намагнічування трансформатора (inrush).
 *          Диференційний захист блокується за 2-ю гармонікою, типовий
 *          поріг 15..20%. Без неї перевірити блокування неможливо.
 *   3-я  - захист від замикань на землю в обмотці статора генератора
 *          (схема на 3-й гармоніці, 100% stator earth fault), а також
 *          насичення ТС і нульова послідовність.
 *   4-а  - разом із 2-ю утворює сигнатуру inrush; частина реле рахує
 *          суму парних.
 *   5-а  - КЛЮЧОВА. Перезбудження (overexcitation / overfluxing)
 *          трансформатора, блокування дифзахисту, типовий поріг 25..35%.
 *   7-а  - перевантаження перетворювачами, фільтри вищих гармонік.
 *   9-а  - контроль фільтрів, нульова послідовність (кратна 3).
 *  11,13 - класичні для 6- і 12-пульсних перетворювачів; потрібні для
 *          перевірки захистів у мережах із тяговим/промисловим приводом.
 *
 * Тобто мінімальний обов'язковий набір - 2, 3, 4, 5. До 10-ї включно
 * (як ти й хотів) покриває все, що впливає на логіку РЗА; 11 і 13
 * лишаються "power quality" і на роботу захистів впливають мало.
 * Аперіодична складова з постійною часу (нижче) - окремо, вона потрібна
 * для перевірки насичення ТС і роботи дистанційного захисту.
 */
#define WG_HARMONIC_MAX_ORDER          10U
#define WG_HARMONIC_COUNT              WG_HARMONIC_MAX_ORDER

/* ==========================================================================
 * 4. Sine LUT
 * ==========================================================================
 * 512 точок + лінійна інтерполяція. Похибка апроксимації ~ (pi/512)^2/2,
 * тобто близько -94 dB - на два порядки менше, ніж шум 12-бітного ADC.
 * Без інтерполяції для тієї ж якості знадобився б LUT на 16k точок.
 */
#define WG_LUT_SIZE                    512U
#define WG_LUT_MASK                    (WG_LUT_SIZE - 1U)
#define WG_LUT_INDEX_SHIFT             23U      /* 32 - log2(512) */
#define WG_LUT_FRAC_SHIFT              15U      /* WG_LUT_INDEX_SHIFT - 8 */

/* ==========================================================================
 * 5. Шкала ADC
 * ==========================================================================
 * Диференційний режим: 2048 = нульова різниця входів, повна шкала +-2047.
 */
#define WG_ADC_FULL_SCALE              4095
#define WG_ADC_MIDPOINT                2048
#define WG_ADC_HALF_RANGE              2047

/* ==========================================================================
 * 6. Обмеження duty
 * ==========================================================================
 * Обмеження HRTIM (RM0364, табл. "compare value constraints"): при
 * CKPSC[2:0] = 0 (MUL32) значення compare має бути >= 0x0060 = 96 і
 * не більше period - 0x0060. Попередня версія використовувала 32, що цю
 * вимогу порушує і дає непередбачувану поведінку на краях діапазону.
 */
#define WG_COMPARE_MIN_TICKS           96U      /* апаратний мінімум для MUL32 */
#define WG_DUTY_MARGIN_TICKS           128U     /* із запасом до апаратного мінімуму */

/* ==========================================================================
 * 7. Значення сигналу за замовчуванням
 * ==========================================================================
 */
#define WG_DEFAULT_FREQ_MILLIHZ        50000UL  /* 50.000 Hz */
#define WG_DEFAULT_AMPLITUDE_ADC       1200     /* амплітуда основної, відліки ADC */
#define WG_DEFAULT_APERIODIC_ADC       0
#define WG_DEFAULT_TAU_MS              40U      /* 0 => постійне зміщення без згасання */

/* Фазові зсуви каналів за замовчуванням: пряма послідовність A-B-C. */
#define WG_DEFAULT_PHASE_CH0_DEG_MILLI 0L
#define WG_DEFAULT_PHASE_CH1_DEG_MILLI (-120000L)
#define WG_DEFAULT_PHASE_CH2_DEG_MILLI (120000L)
#define WG_DEFAULT_PHASE_CH3_DEG_MILLI 0L

/* ==========================================================================
 * 8. Регулятор - НОРМОВАНІ коефіцієнти
 * ==========================================================================
 * Структура закону керування на кожному такті контуру:
 *
 *   ref  = 2048 + sum(гармоніки) + аперіодична          [відліки ADC]
 *   fb   = (raw - offset) * scale                       [відліки ADC]
 *   err  = ref_dev - fb
 *
 *   duty = center + FF*ref_dev + clamp(KP*err + I + R, +-LIM)
 *
 * ВАЖЛИВО: коефіцієнти нижче задані НОРМОВАНО - у частках підсилення
 * об'єкта, а не в тіках duty на відлік ADC. Реальні коефіцієнти отримуються
 * множенням на 1/P, де P - виміряне на старті підсилення об'єкта
 * (див. розділ 11). Тобто KP = 0.2 означає «петльове підсилення 0.2 по
 * пропорційному каналу» незалежно від напруги живлення й дільників.
 *
 * Це принципово для роботи без UART: інакше коефіцієнти довелося б
 * підбирати вручну під конкретне залізо, а підібрати їх нема чим.
 *
 * Навіщо резонатор: PI має скінченне підсилення на 50 Гц, тому на змінному
 * завданні завжди лишається стала похибка по амплітуді й фазі. Резонансний
 * член дає підсилення KR рівно на основній частоті, тобто залишкова похибка
 * стає 1/(1+KR). При KR = 5 це 17 %, при KR = 20 - 5 %.
 *
 * Резонатор тут дуже стійкий: він діє лише на 50 Гц, а на цій частоті
 * LC-фільтр (резонанс якого на порядки вище) фази майже не крутить, і
 * затримка контуру ~40 мкс дає лише 0.7°. Тому KR можна сміливо піднімати
 * до 20, якщо залишкова похибка амплітуди ще помітна на осцилографі.
 */
#define WG_FF_NORM                     1.0f     /* точний feedforward        */
#define WG_PI_KP_NORM                  0.2f     /* петльове підсилення по P  */
#define WG_PI_KI_NORM                  50.0f    /* 1/с; злам ~8 Гц           */
#define WG_PR_KR_NORM                  5.0f     /* підсилення на 50 Гц       */
#define WG_PR_WC_DEFAULT               31.4f    /* смуга резонатора, рад/с   */

/* Максимальний внесок регулятора (PI + резонатор) у тіках duty. */
#define WG_LOOP_OUT_LIMIT_TICKS        8000.0f

/* Якщо |err| перевищує поріг - інтегратор і резонатор заморожуються.
 * Це і anti-windup, і захист від «розгону» при пошкодженні кола ЗЗ. */
#define WG_ERROR_FREEZE_ADC            1500

/* Скільки тактів поспіль ЗЗ може бути в насиченні (0 або 4095), перш ніж
 * канал автоматично перейде в розімкнений контур. */
#define WG_FEEDBACK_FAULT_TICKS        200U

/* ==========================================================================
 * 9. Автостарт
 * ==========================================================================
 * Без UART прошивка має почати генерувати сама. Амплітуда наростає з нуля
 * за WG_AUTOSTART_RAMP_MS - різкий старт на повну амплітуду дав би кидок
 * струму через LC і перерегулювання, яке довелося б довго заспокоювати.
 */
#define WG_AUTOSTART                   1
#define WG_AUTOSTART_RAMP_MS           300U

/* ==========================================================================
 * 10. Калібрування каналу вимірювання
 * ==========================================================================
 * offset - реальний код ADC при нульовому сигналі (у диф. режимі має бути
 *          близько 2048, але зсув підсилювача це змінює);
 * scale  - у скільки разів відлік ЗЗ треба помножити, щоб він потрапив
 *          у ту саму шкалу, що й завдання (враховує коефіцієнт дільника,
 *          підсилення й будь-яку інверсію - для інверсного каналу scale
 *          від'ємний).
 *
 * Знімається так: LOOP=0, подати відому амплітуду, подивитись FBPK у
 * відповіді GET STATE, порахувати scale = завдана_амплітуда / виміряна.
 */
#define WG_FB_OFFSET_DEFAULT           2048
#define WG_FB_SCALE_DEFAULT            1.0f

/* ==========================================================================
 * 11. Самокалібрування об'єкта на старті
 * ==========================================================================
 *
 * Замикати контур наосліп не можна. Найнебезпечніше - ЗНАК: якщо вхідне
 * коло інвертує, зворотний зв'язок стає додатним і вихід миттєво йде в
 * полицю. А без UART ні знак, ні підсилення об'єкта підібрати нема чим.
 *
 * Тому на старті прошивка сама визначає передавальну характеристику
 * «тіки duty -> відліки ADC» і лише після цього замикає контур:
 *
 *   1. SETTLE - амплітуда нуль, duty = центр. Чекаємо, поки заспокоїться
 *      LC, і водночас усереднюємо ЗЗ: це дає offset_adc (реальний код АЦП
 *      при нульовому сигналі).
 *
 *   2. PROBE - розімкнений контур, синус малої амплітуди. Накопичуємо
 *      суми Sum(ref*fb) і Sum(ref*ref) за кілька періодів. Їхнє відношення
 *      g = Sum(ref*fb)/Sum(ref*ref) - це оцінка підсилення наскрізного
 *      тракту методом найменших квадратів, РАЗОМ ЗІ ЗНАКОМ. Кореляційна
 *      оцінка стійка до пульсацій і шуму: усе, що не корельоване з
 *      завданням, у сумі прямує до нуля.
 *
 *      Якщо відгук замалий, проба повторюється з учетверо більшим
 *      feedforward, до WG_CAL_ATTEMPTS разів. Так тракт із будь-яким
 *      напруженням живлення знаходиться сам.
 *
 *   3. APPLY - усі коефіцієнти множаться на 1/P, контур замикається,
 *      амплітуда наростає до робочої.
 *
 * Проба ТІЛЬКИ ЗМІННИМ СТРУМОМ, без постійної складової: постійна на
 * трансформаторному виході ввела б осердя в насичення.
 *
 * Якщо калібрування не вдалося (обрив ЗЗ, підсилення поза межами) - канал
 * лишається в розімкненому контурі з безпечним feedforward і піднімає
 * прапорець. Сигнал усе одно генерується, просто без корекції.
 */
#define WG_AUTOCAL                     1

/* Стартовий feedforward для проби, тіки duty на відлік ADC. Свідомо малий:
 * при амплітуді проби 200 відліків це 400 тіків з 23040, тобто 1.7 %
 * модуляції - безпечно для будь-якого силового каскаду. */
#define WG_CAL_FF_PROBE                2.0f
#define WG_CAL_PROBE_AMPLITUDE_ADC     200
#define WG_CAL_ATTEMPTS                4U       /* кожна наступна x4        */
#define WG_CAL_MAX_MODULATION_TICKS    6000     /* стеля модуляції проби    */

#define WG_CAL_SETTLE_MS               150U
#define WG_CAL_SKIP_PERIODS            2U       /* пропустити перехідний    */
#define WG_CAL_MEASURE_PERIODS         6U

/* Межі правдоподібності виміряного підсилення. Поза ними вважаємо, що
 * канал вимірювання не працює, і контур не замикаємо. */
#define WG_CAL_G_MIN                   0.02f
#define WG_CAL_G_MAX                   200.0f

/* Межі підсумкового feedforward після масштабування. */
#define WG_FF_MIN                      0.1f
#define WG_FF_MAX                      200.0f

/* Частка діапазону duty, яку дозволено зайняти основній гармоніці.
 *
 * Після калібрування ff = 1/P, і потрібна модуляція duty дорівнює
 * ff * амплітуду. Якщо силовий каскад «слабкий» (мала напруга шини або
 * великий дільник у колі вимірювання), ff виходить великим, і задана
 * амплітуда просто не поміщається в діапазон шпаруватості. Раніше це дало
 * б обрізаний синус - найгірше з можливого для імітатора.
 *
 * Тому робоча амплітуда автоматично обмежується тим, що реально досяжне,
 * а решта запасу лишається регулятору на корекцію. */
#define WG_AMP_HEADROOM                0.9f

/* ==========================================================================
 * 12. Емуляція грубішої роздільності PWM (експеримент під перехід на H7)
 * ==========================================================================
 *
 * STM32H743 має HRTIM без DLL x32: роздільність 2.08 нс замість 217 пс у
 * F334. При PWM 100 кГц це 4808 кроків duty замість 46080, тобто 12.2 біта
 * замість 15.5. Питання "чи це прийнятно" не можна вирішити теоретично -
 * усе залежить від силового каскаду й LC-фільтра.
 *
 * Але його можна вирішити ПРЯМО НА ЦІЙ ПЛАТІ. 46080 / 4808 = 9.6, тому
 * квантування compare кроком 10 тіків дає точну (навіть трохи песимістичну)
 * емуляцію H743 у твоєму реальному тракті.
 *
 * Порядок експерименту - три вимірювання THD і рівнів окремих гармонік
 * при одному й тому самому завданні:
 *
 *   1) WG_DUTY_QUANT_TICKS = 0            -> рідні 15.5 біта, еталон
 *   2) WG_DUTY_QUANT_TICKS = 10, DITHER 0 -> H743 у найгіршому випадку
 *   3) WG_DUTY_QUANT_TICKS = 10, DITHER 1 -> H743 із пом'якшенням
 *
 * Якщо (3) близьке до (1) - переходити на H743 безпечно. Якщо (3) ближче
 * до (2) - силовий каскад чутливий до квантування, і треба або знижувати
 * PWM до 50 кГц (13.2 біта), або лишатись на G4 з окремим мережевим чіпом.
 *
 * Навіщо дизеринг. Похибка квантування PWM не біла - вона корельована із
 * сигналом і вилазить саме як зайві гармоніки. Для імітатора РЗА це
 * критично: ти навмисно подаєш 2-у гармоніку на рівні 15 %, і власні
 * гармоніки квантування підмішуються прямо в неї. Додавання рівномірного
 * шуму в один крок квантування ПЕРЕД усіченням розриває цю кореляцію -
 * гармоніки перетворюються на рівномірний шумовий фон, який LC-фільтр і
 * передискретизація давлять.
 */
#define WG_DUTY_QUANT_TICKS            0U   /* 0 = вимкнено; 10 ~= STM32H743 */
#define WG_DUTY_DITHER                 1    /* 1 = дизеринг перед усіченням  */

/* ==========================================================================
 * 13. Черга запланованих змін
 * ==========================================================================
 */
#define WG_UPDATE_QUEUE_CAPACITY       6U

#endif /* WAVE_GENERATOR_CONFIG_H_ */
