tymokhin/VoltageImitator/firmware/STM32CubeIDE/Core/Inc/main.h

#define PWM_PERIOD 46080
#define PPS_Pin GPIO_PIN_13
#define PPS_GPIO_Port GPIOC
#define ENC_A_Pin GPIO_PIN_0
#define ENC_A_GPIO_Port GPIOA
#define ENC_B_Pin GPIO_PIN_1
#define ENC_B_GPIO_Port GPIOA
#define ENC_KEY_Pin GPIO_PIN_2
#define ENC_KEY_GPIO_Port GPIOB
#define LCD_RESET_Pin GPIO_PIN_15
#define LCD_RESET_GPIO_Port GPIOA
#define LCD_SCK_Pin GPIO_PIN_3
#define LCD_SCK_GPIO_Port GPIOB
#define LCD_DS_RS_Pin GPIO_PIN_4
#define LCD_DS_RS_GPIO_Port GPIOB
#define LCD_SDI_Pin GPIO_PIN_5
#define LCD_SDI_GPIO_Port GPIOB
#define LCD_CS_Pin GPIO_PIN_6
#define LCD_CS_GPIO_Port GPIOB
#define LAN_CFG_Pin GPIO_PIN_8
#define LAN_CFG_GPIO_Port GPIOB
#define LAN_RESET_Pin GPIO_PIN_9
#define LAN_RESET_GPIO_Port GPIOB
