tymokhin/VoltageImitator/(commit log)

2026-08-24 snapshot before repo split
    [Board.PcbDoc, Channel.SchDoc, LAN.SchDoc, Main.SchDoc, OdbCache.cfg, Power.SchDoc, Voltage Mesaurment (clode).ms14, Voltage Mesaurment (unipolr stm32).ms14]
2026-08-24 hardware: remove PDNAnalyzer_Output cache, add .gitignore
    [OdbCache.cfg]
2026-08-24 hardware: flatten v1 into hardware/, move v2 out (to branch)
    [Board.PcbDoc, Channel.SchDoc, LAN.SchDoc, Main.SchDoc, Power.SchDoc, VoltageImitator.PrjPcb, VoltageImitator_v2.PrjPcb]
2026-08-24 hardware: move Altium binaries to Git LFS
    [Board.PcbDoc, Channel.SchDoc, LAN.SchDoc, Main.SchDoc, Power.SchDoc]
2026-08-24 firmware: remove unrelated Test folder
    [test Debug.cfg]
2026-08-24 firmware: track generated Drivers/FreeRTOS to make repo self-contained
